MojTabax2/screamingPumpkin/image (1).png

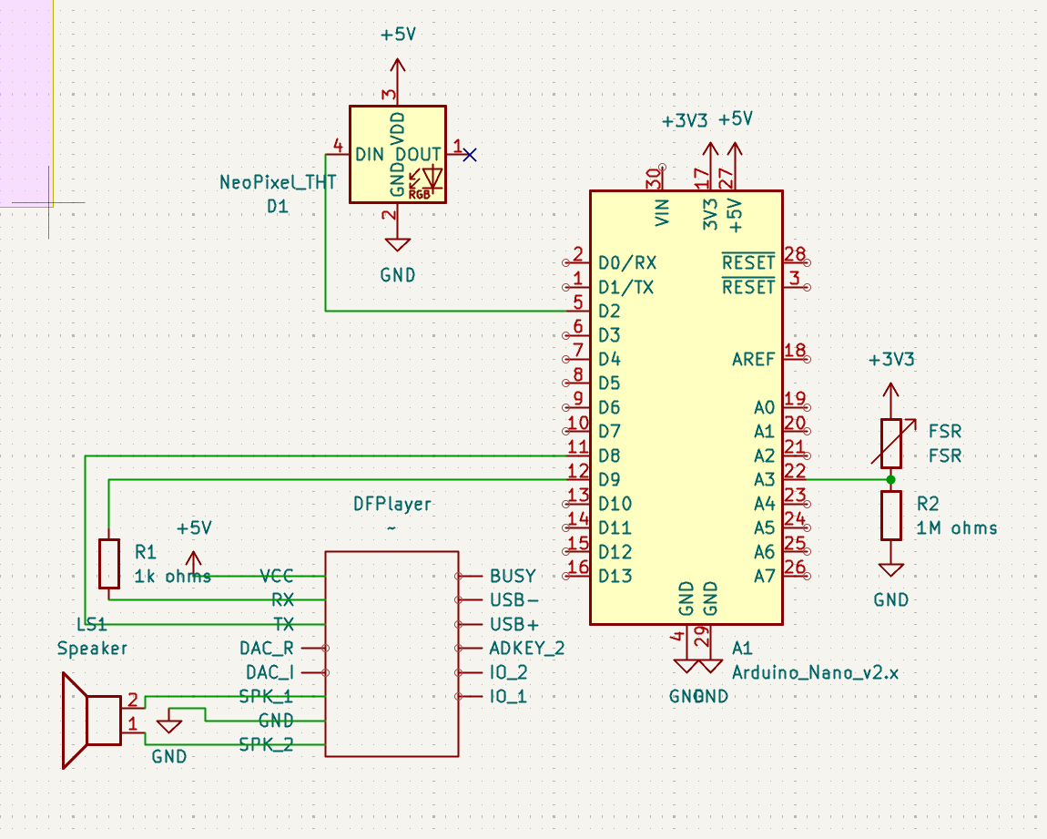
image (1).png
